awd1779/spider-bot-8/docs/images/body_inside.png

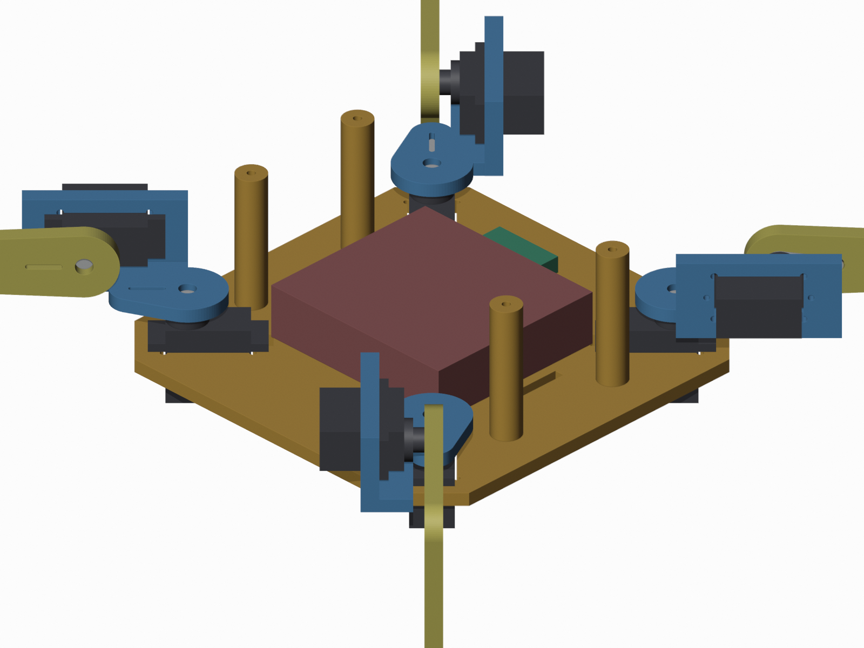
docs/images/body_inside.png
