awd1779/spider-bot-8/docs/images/shoulder_closeup.png

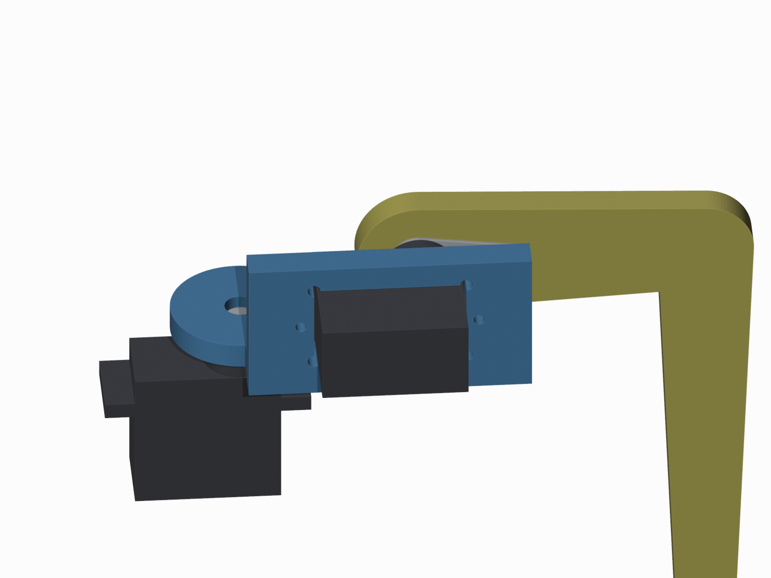
docs/images/shoulder_closeup.png
