awd1779/spider-bot-8/hardware/step/assembly.step

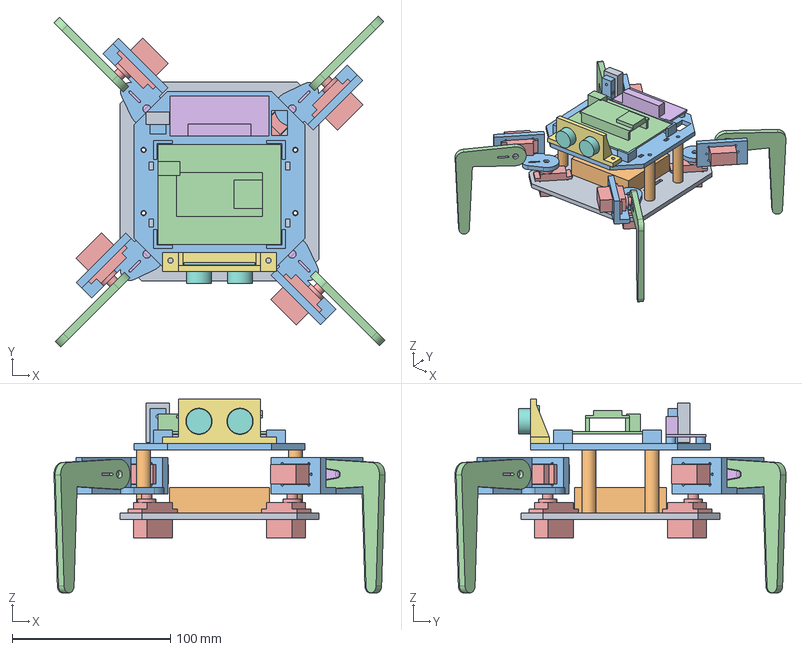
[picture p6: CAD file, 2026-10-23]
hardware/step/assembly.step
209.4 x 209.4 x 122.5 mm
body_bottom
spacer0
spacer1
spacer2
spacer3
body_top
esp32_board
buck_boost_5v
pca9685
sensor_head
sensors_hcsr04_temp
battery_4xAA
leg0_coxa
leg0_leg
leg0_servo_hip
leg0_servo_lift
leg0_horn_hip
leg0_horn_lift
leg1_coxa
leg1_leg
leg1_servo_hip
leg1_servo_lift
leg1_horn_hip
leg1_horn_lift
leg2_coxa
leg2_leg
leg2_servo_hip
leg2_servo_lift
leg2_horn_hip
leg2_horn_lift
leg3_coxa
leg3_leg
leg3_servo_hip
leg3_servo_lift
leg3_horn_hip
leg3_horn_lift
