awd1779/spider-bot-8/hardware/print_one_leg/one_leg_set.stl

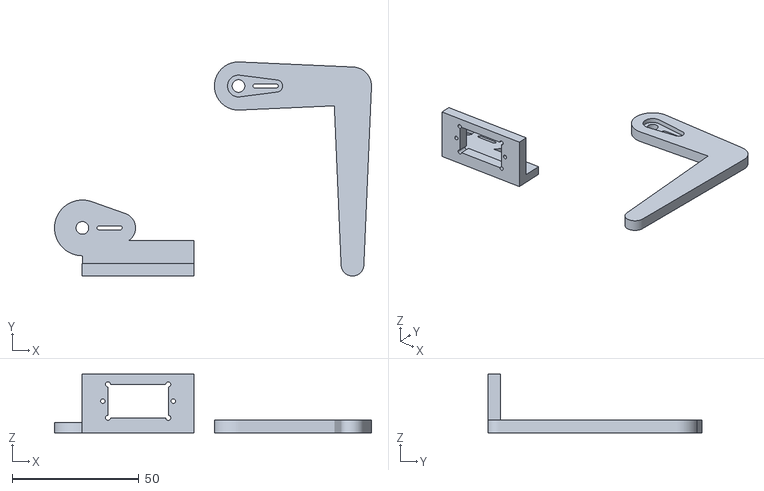
[picture p7: CAD file, 2026-10-23]
hardware/print_one_leg/one_leg_set.stl
125.1 x 84.5 x 23.1
