awd1779/spider-bot-8/hardware/step/spacer.step

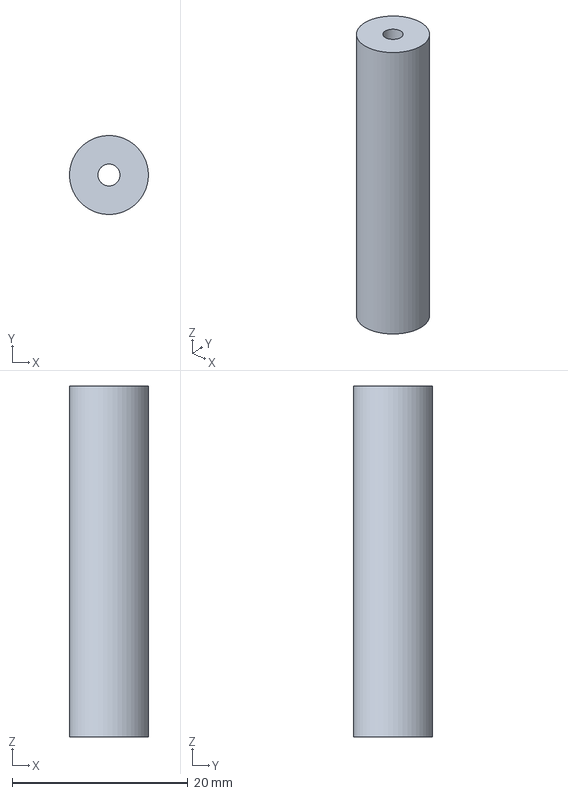
[picture p8: CAD file, 2026-10-23]
hardware/step/spacer.step
8.99 x 9.00 x 40.0 mm
