awd1779/spider-bot-8/hardware/step/leg.step

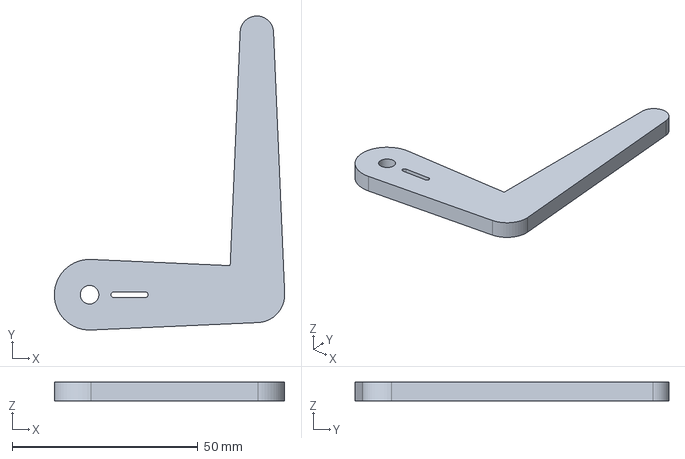
[picture p9: CAD file, 2026-10-23]
hardware/step/leg.step
62.0 x 84.5 x 5.00 mm
