awd1779/spider-bot-8/hardware/step/sensor_head.step

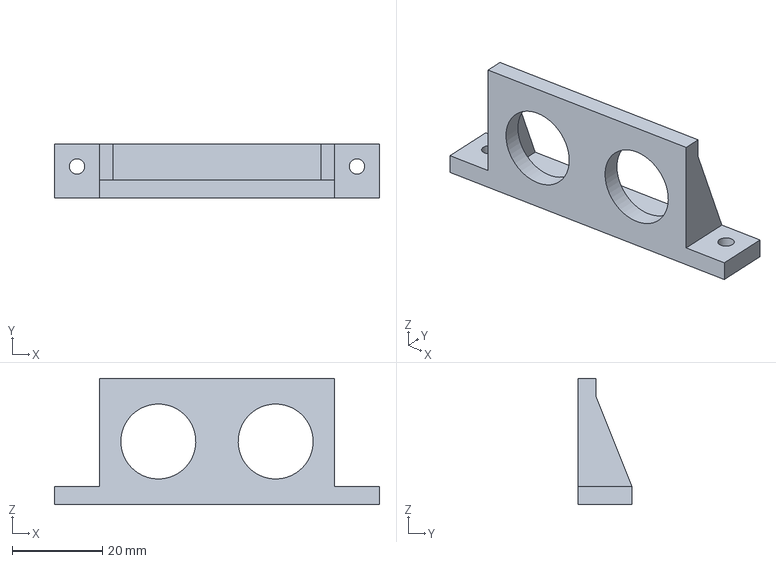
[picture p10: CAD file, 2026-10-23]
hardware/step/sensor_head.step
72.0 x 12.0 x 28.0 mm
