awd1779/spider-bot-8/hardware/step/body_bottom.step

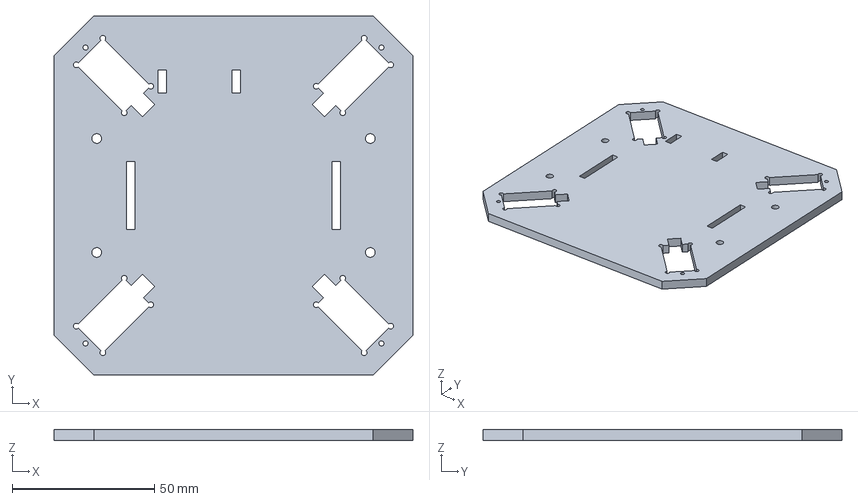
[picture p11: CAD file, 2026-10-23]
hardware/step/body_bottom.step
126.0 x 126.0 x 4.00 mm
