awd1779/spider-bot-8/hardware/step/body_top.step

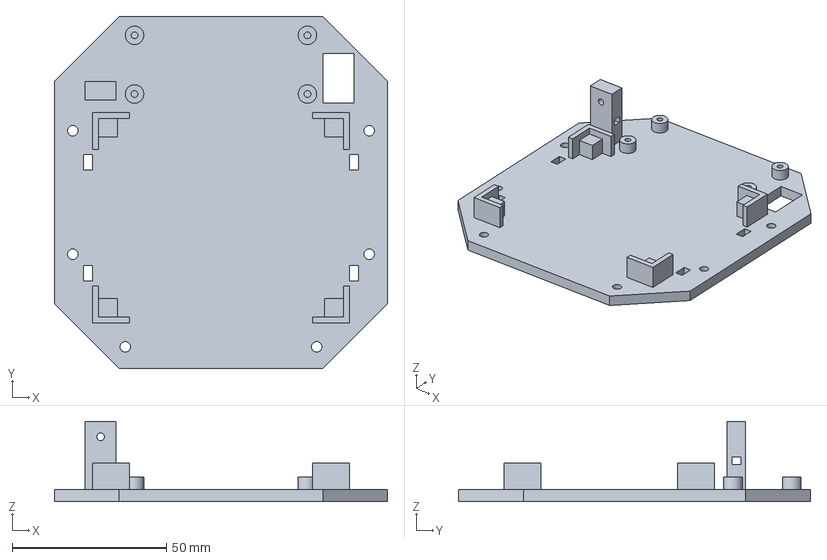
[picture p12: CAD file, 2026-10-23]
hardware/step/body_top.step
108.0 x 114.0 x 26.0 mm
