awd1779/spider-bot-8/hardware/step/leg_test_stand.step

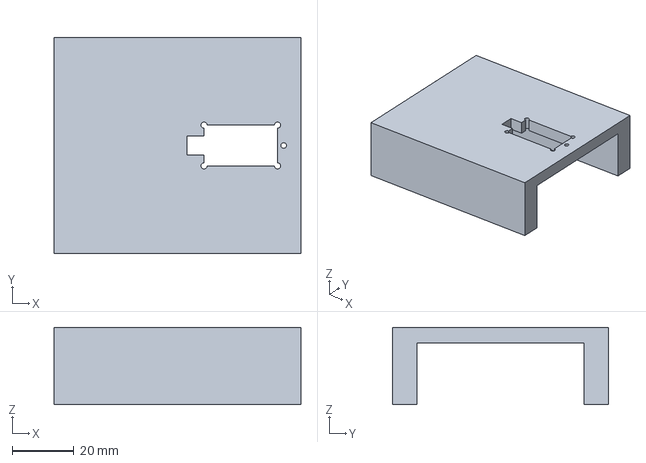
[picture p13: CAD file, 2026-10-23]
hardware/step/leg_test_stand.step
80.0 x 70.0 x 25.0 mm
