awd1779/spider-bot-8/hardware/step/fit_test.step

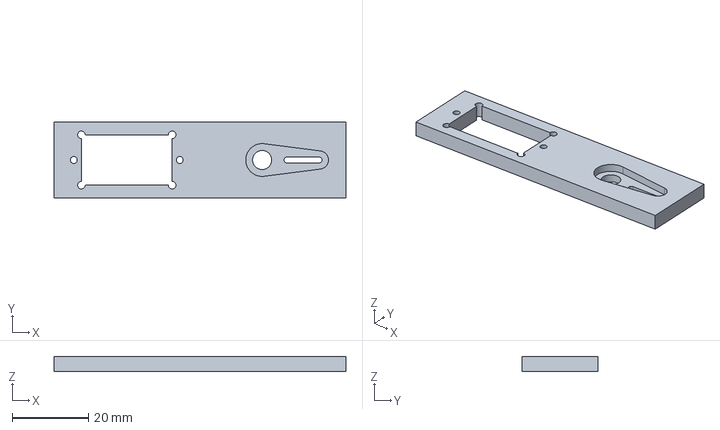
[picture p14: CAD file, 2026-10-23]
hardware/step/fit_test.step
76.6 x 20.0 x 4.00 mm
