awd1779/spider-bot-8/hardware/step/coxa.step

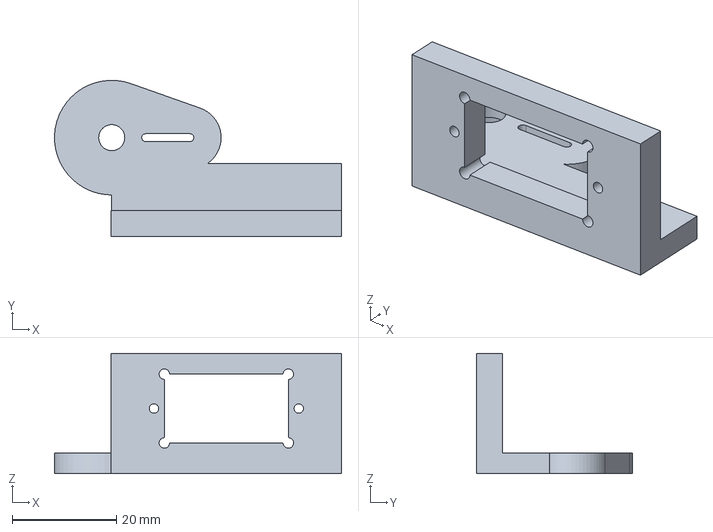
[picture p15: CAD file, 2026-10-23]
hardware/step/coxa.step
55.1 x 30.0 x 23.1 mm
