awd1779/spider-bot-8/hardware/step/leg_interface.step

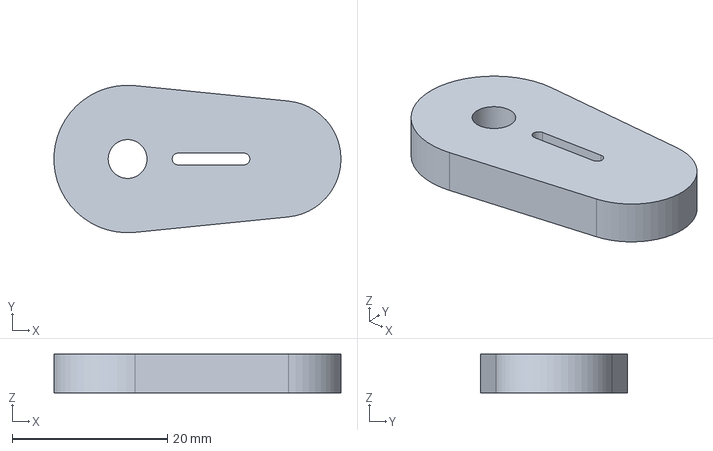
[picture p16: CAD file, 2026-10-23]
hardware/step/leg_interface.step
37.0 x 19.0 x 5.00 mm
