awd1779/spider-bot-8/hardware/step/screw_test.step

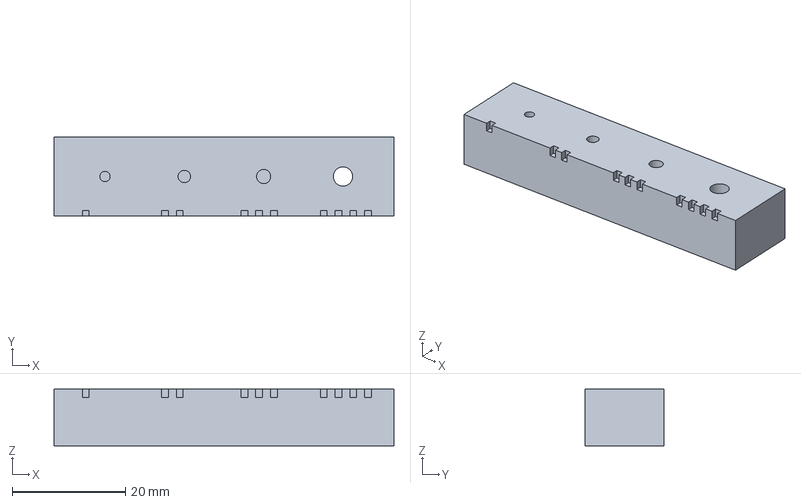
[picture p17: CAD file, 2026-10-23]
hardware/step/screw_test.step
60.0 x 14.0 x 10.0 mm
