awd1779/spider-bot-8/(list of files, cad)

Other CAD files:
hardware/stl/body_bottom.stl
hardware/stl/body_top.stl
hardware/stl/coxa.stl
hardware/stl/fit_test.stl
hardware/stl/leg.stl
hardware/stl/leg_interface.stl
hardware/stl/leg_test_stand.stl
hardware/stl/screw_test.stl
hardware/stl/sensor_head.stl
hardware/stl/spacer.stl
