awd1779/spider-bot-8/docs/manual.html

Student manual · ESP32 + PCA9685 · 8 servos

# Build a walking spider robot

From one servo motor to a robot that walks forward and backward. Work through the chapters in order. Tick the boxes as you go: this page remembers them on this computer.

## Welcome

In this manual you build a four-legged spider robot and teach it to stand up, sit down and walk forward and backward. Each chapter adds one idea and ends with a short check.

The finished spider robot: ESP32 and servo module on top, 4 × AA batteries inside, 8 servos in the legs

The finished spider robot: ESP32 and servo module on top, 4 × AA batteries inside, 8 servos in the legs

The chapters

1. How servo motors work
2. The servo module (PCA9685)
3. Controlling servo motors with code
4. Assembly and calibration
5. Stand up and sit down
6. Walk forward
7. Walk backward
8. The easy way: the SpiderBot8 library

Parts

Part | Qty
ESP32 38-pin board on its expansion board, plus USB cable | 1
MG90S servo motor (with single-arm horn and small screws) | 8
PCA9685 16-channel servo module | 1
4 × AA battery holder with switch, plus 4 AA batteries | 1
Jumper wires, female to female | 4
3D-printed parts: body plate, lid, 4 spacers, 4 shoulders, 4 legs, sensor head | 1 set
M2 × 5 or M2 × 6 self-tapping screws (for the horns) | 16
M3 screws (body and lid), M2.5 screws (servo module), zip ties, Velcro strap | 1 set

Software (set up once)

1. Install Arduino IDE 2.
2. Tools → Board → Boards Manager: search esp32, install esp32 by Espressif Systems.
3. Tools → Board: choose ESP32 Dev Module. Tools → Port: choose the port that appears when you plug in the ESP32.
4. Tools → Manage Libraries: search Adafruit PWM Servo Driver and install it.
5. In the Serial Monitor, set the speed to 115200 baud and the line ending to Newline.

Upload stuck at "Connecting..."? Hold the BOOT button on the ESP32 until the upload starts, then let go.

Safety rules

- Unplug the batteries before you change any wire.
- The batteries go only into the green terminal on the servo module. Never connect them to the ESP32 pins.
- Never turn a servo shaft by hand. Let the code move it.
- If anything gets hot or smells, switch off the batteries and tell your teacher.

## Chapter 1 · How servo motors work

A servo is a motor that turns to an exact angle and holds it there. An ordinary motor just spins while it has power. A servo checks where its shaft is and keeps correcting until it reaches the angle you asked for. The spider uses 8 of them. On each leg, one swings the leg forward and back (hip), and one lifts it up and down (lift).

### 1.1 What's inside

1. Control board: reads the signal and decides which way to drive the motor.
2. DC motor: small and fast, but weak on its own.
3. Gearbox: metal gears in the MG90S slow the motor down and make it much stronger.
4. Potentiometer: a knob joined to the output shaft. It tells the board the shaft's real angle.

The board compares the angle it was told with the angle the potentiometer reads, and drives the motor until they match. This is called a closed loop. It's why a servo pushes back when you try to move it.

### 1.2 MG90S at a glance

Spec | Value
Rotation | about 0° to 180°
Supply voltage | 4.8 to 6.0 V
Strength (stall torque) | about 1.8 kg·cm at 4.8 V, 2.2 kg·cm at 6 V
Speed | about 0.10 s per 60° at 4.8 V
Current | about 10 mA resting, 100–250 mA moving, up to 700 mA when blocked
Weight | 13.4 g

What does 1.8 kg·cm mean? The servo can just hold 1.8 kg on an arm 1 cm long, or 0.9 kg on an arm 2 cm long. A longer arm makes it weaker. Our robot weighs about 460 g, and each lift servo carries about 115 g at the foot. That's well inside what an MG90S can hold, but only if the foot isn't too far out to the side (Chapter 5).

### 1.3 Pulse length sets the angle

The orange signal wire carries a pulse: it switches on for a short time, then off, 50 times every second (every 20 ms). The length of the on part tells the servo which angle to go to.

Pulse length | Angle
500 µs (0.5 ms) | 0°
975 µs | 45°
1450 µs | 90° (centre)
1925 µs | 135°
2400 µs | 180°

Every 1° adds about 10.56 µs:

pulse (µs) = 500 + angle × 10.56

Drag the slider to see the pulse and the horn move together:

Angle 90°

0°45°90°135°180°

Supply 4.8 V6.0 V

1450 µsDrag the slider or pick an angle

Every degree adds about 10.6 µs

Only the length of the 5 V part matters

The voltage changes the speed, not where it stops

What does the battery voltage change? Not the angle. At 4.8 V or 6 V, a 1450 µs pulse means 90°. A higher voltage only makes the servo faster and stronger. Flat batteries make it weak, slow and jittery.

### 1.4 The three wires

Wire colour | Job | Goes to
Brown | GND (−) | battery − (through the servo module)
Red | power (+), 4.8–6 V | battery + (through the servo module)
Orange | signal (the pulse) | a servo module channel

### 1.5 The horn and its teeth

The horn pushes onto the shaft's teeth (the spline). The MG90S shaft has about 20 teeth, so the horn can only go on in steps of about 18°. It's very unlikely to point exactly where you want: it will usually be a few degrees off. That's why we centre every servo with code before fitting the horn (4.2), then fix the last few degrees with trim numbers in the code (4.9).

Check yourself (Chapter 1)

- What part inside the servo measures the real angle?
- What pulse length gives 90°? And 135°?
- Does a higher battery voltage change the angle? What does it change?
- Why can't a horn point at exactly any angle you like?

## Chapter 2 · The servo module (PCA9685)

The ESP32 could make servo pulses itself, but 8 servos cause two problems:

- Power: 8 moving servos can pull 2–3 A. The ESP32 and its USB cable can give only about 0.5 A. The board would keep resetting.
- Pins and timing: 8 servos need 8 pins all sending perfect pulses, all the time, while the ESP32 is busy with other jobs.

The PCA9685 module solves both. It makes the pulses for up to 16 servos by itself. The servos take their power from the batteries through the module's green terminal, not from the ESP32. The ESP32 only sends commands like "channel 4: 1450 µs" over two wires called I2C.

### 2.1 The module's pins

Pin | Job | Connect to
GND | ground | ESP32 GND
OE | output enable | leave it unconnected
SCL | I2C clock | ESP32 GPIO 22
SDA | I2C data | ESP32 GPIO 21
VCC | power for the chip (3.3 V) | ESP32 3V3
V+ | servo power | leave it: the green terminal feeds it
Green terminal | servo power in | 4 × AA pack: red to V+, black to GND
16 × 3-pin rows | servo plugs, channels 0–15 | brown wire on the GND side

I2C is a way for chips to talk over two shared wires, SDA (data) and SCL (clock). Every device has an address. The PCA9685 is at 0x40.

### 2.2 Wiring

Four wires between the boards, the battery only into the green terminal.

There are two separate power supplies here. The USB cable powers the ESP32, and the ESP32's 3V3 pin powers the module's chip. The batteries power only the servos. The GND wire joins the two, so the signals have a common reference.

Check the battery polarity at the green terminal before you switch on: red to V+, black to GND. The wrong way round can destroy the module.

### 2.3 Activity: find the module

Upload this sketch, open the Serial Monitor, and check that the ESP32 can see the module.

Copy

// spider-bot-8 by DRODI | MIT licence | https://github.com/awd1779/spider-bot-8
// P1 - I2C scanner
// Finds every I2C device on SDA / SCL and prints its address.
// The PCA9685 servo module should show up as 0x40.
// ESP32: SDA = GPIO 21, SCL = GPIO 22

#include <Wire.h>

void setup() {
  Serial.begin(115200);
  Wire.begin();
  delay(500);
  Serial.println("Scanning I2C...");
}

void loop() {
  int found = 0;
  for (int address = 1; address < 127; address++) {
    Wire.beginTransmission(address);
    if (Wire.endTransmission() == 0) {        // 0 = a device answered
      Serial.print("Found a device at 0x");
      if (address < 16) Serial.print("0");
      Serial.println(address, HEX);
      found++;
    }
  }
  if (found == 0) Serial.println("Nothing found. Check VCC, GND, SDA and SCL.");
  Serial.println("---");
  delay(3000);                                 // scan again every 3 seconds
}

Code | What it does
Wire.begin(); | Starts I2C. On the ESP32 that's SDA = GPIO 21, SCL = GPIO 22
Wire.beginTransmission(address); | "Is anyone at this address?"
Wire.endTransmission() == 0 | 0 means a device answered
Serial.println(address, HEX); | Prints the address in hexadecimal, like 40

You should see Found a device at 0x40. If you see "Nothing found", check the four wires: VCC, GND, SDA and SCL. SDA and SCL swapped is the most common mistake.

Check yourself (Chapter 2)

- Give two reasons we use the servo module instead of plugging servos into the ESP32.
- Which two wires does I2C use? What are they connected to on the ESP32?
- Where do the batteries connect? Where must they never connect?
- The scanner found 0x40. What is at that address?

## Chapter 3 · Controlling servo motors

### 3.1 Activity: move one servo

Plug one servo into channel 0, brown wire on the GND side. Switch on the batteries, then upload:

Copy

// spider-bot-8 by DRODI | MIT licence | https://github.com/awd1779/spider-bot-8
// P2 - Move one servo with the PCA9685
// Servo on channel 0. It goes to 90, 45 and 135 degrees, then sweeps smoothly.

#include <Wire.h>
#include <Adafruit_PWMServoDriver.h>

Adafruit_PWMServoDriver pca = Adafruit_PWMServoDriver(0x40);

// Angle (0 to 180) -> pulse length in microseconds, then send it
void writeServo(int channel, float angle) {
  int us = 500 + angle * 10.56;
  pca.writeMicroseconds(channel, us);
}

void setup() {
  Wire.begin();                       // ESP32: SDA = 21, SCL = 22
  pca.begin();
  pca.setOscillatorFrequency(27000000);
  pca.setPWMFreq(50);                 // servos want 50 pulses a second
  delay(10);

  writeServo(0, 90);  delay(1000);    // centre
  writeServo(0, 45);  delay(1000);
  writeServo(0, 135); delay(1000);
  writeServo(0, 90);  delay(1000);
}

void loop() {
  for (int a = 90; a <= 135; a++) {   // count up, 1 degree at a time
    writeServo(0, a);
    delay(15);                        // 15 ms per degree sets the speed
  }
  for (int a = 135; a >= 45; a--) {   // count back down
    writeServo(0, a);
    delay(15);
  }
  for (int a = 45; a <= 90; a++) {    // back to the centre
    writeServo(0, a);
    delay(15);
  }
  delay(500);
}

Code | What it does
#include <Adafruit_PWMServoDriver.h> | Loads the library that talks to the PCA9685

Adafruit_PWMServoDriver pca = ...(0x40); | Creates pca, the module at address 0x40
pca.setPWMFreq(50); | 50 pulses a second: what servos expect
pca.setOscillatorFrequency(27000000); | Tells the library the chip's real clock speed, so the pulse lengths come out right
void writeServo(int channel, float angle) | Our own function: changes an angle into a pulse length (1.3) and sends it
pca.writeMicroseconds(channel, us); | "Channel 0: send pulses this many µs long", from now until we say otherwise
for (int a = 90; a <= 135; a++) | Counts 90, 91, 92 ... 135. Moving 1° at a time makes the movement smooth
delay(15); | 15 ms per degree. Smaller is faster

Try it: change delay(15) to delay(5), then to delay(40). What happens?

### 3.2 Activity: the servo tester

This sketch lets you type any channel and angle. You'll use it again to check servos and wiring.

Copy

// spider-bot-8 by DRODI | MIT licence | https://github.com/awd1779/spider-bot-8
// P3 - Servo tester
// Type a channel and an angle in the Serial Monitor (115200 baud, "Newline"), e.g.
//   0 90     -> channel 0 to 90 degrees
//   5 120    -> channel 5 to 120 degrees
// It prints the pulse length it sent.

#include <Wire.h>
#include <Adafruit_PWMServoDriver.h>

Adafruit_PWMServoDriver pca = Adafruit_PWMServoDriver(0x40);

int writeServo(int channel, float angle) {
  int us = 500 + angle * 10.56;
  pca.writeMicroseconds(channel, us);
  return us;
}

void setup() {
  Serial.begin(115200);
  Wire.begin();
  pca.begin();
  pca.setOscillatorFrequency(27000000);
  pca.setPWMFreq(50);
  delay(10);
  Serial.println("Type: channel angle   (example: 0 90)");
}

void loop() {
  if (Serial.available() == 0) return;          // nothing typed yet
  String line = Serial.readStringUntil('\n');
  int channel = -1, angle = -1;
  if (sscanf(line.c_str(), "%d %d", &channel, &angle) != 2) {
    Serial.println("Type two numbers, e.g. 0 90");
    return;
  }
  if (channel < 0 || channel > 15 || angle < 0 || angle > 180) {
    Serial.println("Channel 0-15, angle 0-180");
    return;
  }
  int us = writeServo(channel, angle);
  Serial.print("Channel "); Serial.print(channel);
  Serial.print(" -> "); Serial.print(angle);
  Serial.print(" deg = "); Serial.print(us); Serial.println(" us");
}

Code | What it does
Serial.readStringUntil('\n') | Reads one line you typed in the Serial Monitor
sscanf(line.c_str(), "%d %d", &channel, &angle) | Splits the line into two whole numbers. It gives back how many it found
if (channel < 0 || channel > 15 ...) | Ignores numbers that don't make sense, so a typing mistake can't hurt a servo

Try it: type 0 90, then 0 0, then 0 180. Then move the plug to channel 5 and type 5 45.

### 3.3 Activity: one leg takes a step

A leg has two servos: the hip (forward and back) and the lift (up and down). Plug the hip servo into channel 0 and the lift servo into channel 1. A step only works if the moves happen in the right order: lift, swing forward, put down, push back.

Copy

// spider-bot-8 by DRODI | MIT licence | https://github.com/awd1779/spider-bot-8
// P4 - Two servos make one leg take a step
// Hip servo on channel 0 (forward / back), lift servo on channel 1 (up / down).

#include <Wire.h>
#include <Adafruit_PWMServoDriver.h>

Adafruit_PWMServoDriver pca = Adafruit_PWMServoDriver(0x40);

const int HIP = 0;     // channel numbers
const int LIFT = 1;

int angleNow[16];      // the PCA9685 can't tell us where a servo is, so we remember

void writeServo(int channel, int angle) {
  pca.writeMicroseconds(channel, 500 + angle * 10.56);
  angleNow[channel] = angle;
}

// Move one servo slowly from where it is now to a new angle
void moveSlow(int channel, int target) {
  int step = (target > angleNow[channel]) ? 1 : -1;
  while (angleNow[channel] != target) {
    writeServo(channel, angleNow[channel] + step);
    delay(8);
  }
}

void setup() {
  Wire.begin();
  pca.begin();
  pca.setOscillatorFrequency(27000000);
  pca.setPWMFreq(50);
  delay(10);
  writeServo(HIP, 90);
  delay(300);
  writeServo(LIFT, 90);
  delay(1000);
}

void loop() {
  moveSlow(LIFT, 115);   // 1. lift the foot
  moveSlow(HIP, 110);    // 2. swing it forward in the air
  moveSlow(LIFT, 90);    // 3. put it down
  moveSlow(HIP, 90);     // 4. push back along the ground
  delay(500);
}

Code | What it does
int angleNow[16]; | An array: 16 numbers in a row, one for each channel. The module can't tell us where a servo is, so the code remembers it
angleNow[channel] = angle; | Remembers where we sent it
void moveSlow(int channel, int target) | Moves one servo 1° at a time from where it is now to target
(target > angleNow[channel]) ? 1 : -1 | Count up (+1) if the target is bigger, otherwise down (−1)
while (angleNow[channel] != target) | Keep going until it gets there

Try it: swap lines 2 and 3 in loop(). The foot now drags along the floor. Why?

### 3.4 From servo angles to leg angles

In the robot code we stop thinking in servo angles (0–180) and think in leg angles instead. 0 means the middle:

Leg angle | Meaning
hip = 0 | the leg points straight out
hip > 0 | the foot moves forward (towards the sensor head)
lift = 0 | the top of the leg is level
lift > 0 | the foot goes up
lift < 0 | the foot goes down, pushing the body up

The code changes leg angles into servo angles with one line:

servo angle = 90 + DIR × leg angle + TRIM

- TRIM fixes the few degrees the horn is off (1.5).
- DIR is +1 or −1. The servos on the left and right sides face opposite ways, so the same servo turn moves a left foot back but a right foot forward. DIR flips it so that "+" always means forward.

You'll find each leg's TRIM and DIR in Chapter 4.

Check yourself (Chapter 3)

- What does pca.writeMicroseconds(0, 1450) do?
- Why does the code keep the angles in an array?
- In 3.3, why must the foot lift before the hip swings forward?
- A leg has TRIM = 4 and DIR = −1. Which servo angle gives hip = 10?

## Chapter 4 · Assembly and calibration

The robot pulled apart: bottom plate with the battery inside, 4 spacers, lid with the ESP32 board and servo module, and the 4 legs

The robot pulled apart: bottom plate with the battery inside, 4 spacers, lid with the ESP32 board and servo module, and the 4 legs

### 4.1 Before you start

Printed part | Qty
body_bottom (flat plate) | 1
body_top (lid) | 1
spacer (lid pillars) | 4
coxa (shoulder) | 4
leg | 4
sensor_head | 1

Print one shoulder and one leg first and test them (4.2–4.4) before printing the rest.

### 4.2 Centre every servo first

Plug all 8 servos into the module: channels 0, 1, 4, 5, 8, 9, 12 and 13. Switch on the batteries and upload:

Copy

// spider-bot-8 by DRODI | MIT licence | https://github.com/awd1779/spider-bot-8
// P5 - Centre all 8 servos (run this BEFORE you fit the horns)
// Every leg servo goes to exactly 90 degrees (1450 us) and stays there.
// Leave it running while you push the horns and legs on.

#include <Wire.h>
#include <Adafruit_PWMServoDriver.h>

Adafruit_PWMServoDriver pca = Adafruit_PWMServoDriver(0x40);

const int CHANNELS[8] = {0, 1, 4, 5, 8, 9, 12, 13};   // hip + lift of the 4 legs

void setup() {
  Serial.begin(115200);
  Wire.begin();
  pca.begin();
  pca.setOscillatorFrequency(27000000);
  pca.setPWMFreq(50);
  delay(10);
  for (int i = 0; i < 8; i++) {
    pca.writeMicroseconds(CHANNELS[i], 1450);         // 90 degrees
    delay(300);                                       // one at a time: no big current spike
  }
  Serial.println("All 8 servos are at 90 degrees. Fit the horns now.");
}

void loop() {
}

Every servo is now at exactly 90°. Leave the sketch running while you fit the horns (4.3), so nothing gets pushed off centre. Label each servo with its channel number (a piece of tape on the cable).

### 4.3 Fit the horns

One joint: the horn drops into the pocket on the leg, 2 small screws go through the horn's holes into the slot, and the leg pushes onto the servo

One joint: the horn drops into the pocket on the leg, 2 small screws go through the horn's holes into the slot, and the leg pushes onto the servo

1. Drop a single-arm horn into the pocket on the leg, spline hole facing out.
2. Drive 2 M2 self-tapping screws through 2 horn holes that sit over the slot. Leave a gap between them, for example the 2nd and 5th holes from the centre. The screws cut their own thread into the sides of the slot.
3. Do the same on the flat plate of each shoulder.

### 4.4 Build each leg

One leg built: the hip servo (left), the blue shoulder with the lift servo in its wall, and the yellow leg on the lift servo

One leg built: the hip servo (left), the blue shoulder with the lift servo in its wall, and the yellow leg on the lift servo

1. Push the lift servo through the shoulder's wall, shaft on the leg side, and screw its tabs on with the screws from its bag.
2. Push the leg onto the lift servo's shaft so that the top of the L is level and the foot points down. Fit the servo's small centre screw through the hole in the middle.
3. Repeat for all 4 legs. Every leg is built the same way.

### 4.5 The body

Inside the body: hip servos in the 4 corners, the battery pack in the middle, and the 4 spacers

Inside the body: hip servos in the 4 corners, the battery pack in the middle, and the 4 spacers

1. Push the 4 hip servos into the corners of the bottom plate, shafts up, and screw their tabs on. The cables go down through the notch.
2. Strap the 4 × AA holder to the middle of the plate with the Velcro strap. Bring its wires up to the back-right corner.
3. Screw the 4 spacers on from under the plate with M3 screws.
4. Push each shoulder onto its hip servo so that it points straight out from the corner, diagonally. Fit the centre screw.

### 4.6 The lid

1. Sit the ESP32 expansion board in the 4 corner holders. Pass 2 zip ties through the slots beside it and over the board. The USB socket faces the side.
2. Screw the PCA9685 to the 4 short posts at the back (M2.5).
3. Bolt the sensor head to the 2 front holes (M3).
4. Feed the servo cables and the battery wires up through the slot at the back-right. Screw the lid onto the spacers.

### 4.7 Plug in the servos

Top view: the front (sensor head) is at the top of the picture

Top view: the front (sensor head) is at the top of the picture

Leg | Hip channel | Lift channel
0 rear-left | 0 | 1
1 rear-right | 4 | 5
2 front-right | 8 | 9
3 front-left | 12 | 13

Left and right are as the robot sees them, looking forward. Brown wires go on the GND side of every plug.

### 4.8 Why calibrate?

Every servo is a little different, and the horns sit up to about 9° off (1.5). Calibration finds two numbers for every joint:

- TRIM (degrees): what to add so that leg angle 0 really is straight out and level.
- DIR (+1 or −1): which way round is forward and up for that servo.

### 4.9 Activity: calibrate

Upload this sketch and open the Serial Monitor:

Full sketch: P6_calibrate.ino

Copy

// spider-bot-8 by DRODI | MIT licence | https://github.com/awd1779/spider-bot-8
// P6 - Calibrate the robot
// Open the Serial Monitor (115200 baud, "Newline") and type:
//   test        -> moves each joint a little, one at a time: watch the direction
//   h 0 5       -> hip trim of leg 0 = 5 degrees   (legs: 0 rear-left, 1 rear-right,
//   l 0 -3      -> lift trim of leg 0 = -3 degrees          2 front-right, 3 front-left)
//   fh 0        -> flip the hip direction of leg 0
//   fl 0        -> flip the lift direction of leg 0
//   print       -> prints your numbers, ready to paste into the next sketches

#include <Wire.h>
#include <Adafruit_PWMServoDriver.h>

Adafruit_PWMServoDriver pca = Adafruit_PWMServoDriver(0x40);

const char* LEG_NAME[4] = {"rear-left", "rear-right", "front-right", "front-left"};
const int HIP_CH[4]  = {0, 4, 8, 12};
const int LIFT_CH[4] = {1, 5, 9, 13};

int HIP_TRIM[4]  = {0, 0, 0, 0};
int LIFT_TRIM[4] = {0, 0, 0, 0};
int HIP_DIR[4]   = {-1, 1, 1, -1};
int LIFT_DIR[4]  = {-1, -1, -1, -1};

void writeServo(int ch, float deg) {
  pca.writeMicroseconds(ch, 500 + deg * 10.56);
}

void setLeg(int leg, float hip, float lift) {
  writeServo(HIP_CH[leg], 90 + HIP_DIR[leg] * hip + HIP_TRIM[leg]);
  writeServo(LIFT_CH[leg], 90 + LIFT_DIR[leg] * lift + LIFT_TRIM[leg]);
}

void allZero() {
  for (int leg = 0; leg < 4; leg++) setLeg(leg, 0, 0);
}

void directionTest() {
  for (int leg = 0; leg < 4; leg++) {
    Serial.print("Leg "); Serial.print(leg); Serial.print(" ("); Serial.print(LEG_NAME[leg]);
    Serial.println("): the foot should swing FORWARD (towards the sensor head)");
    setLeg(leg, 20, 0); delay(1200); setLeg(leg, 0, 0); delay(600);
    Serial.println("   ... and now the foot should go UP");
    setLeg(leg, 0, 20); delay(1200); setLeg(leg, 0, 0); delay(600);
  }
  Serial.println("Wrong way? Type fh <leg> or fl <leg>, then test again.");
}

void printNumbers() {
  Serial.println("Copy these 4 lines into the next sketches:");
  const char* names[4] = {"HIP_TRIM", "LIFT_TRIM", "HIP_DIR", "LIFT_DIR"};
  int* arrays[4] = {HIP_TRIM, LIFT_TRIM, HIP_DIR, LIFT_DIR};
  for (int k = 0; k < 4; k++) {
    Serial.print("int "); Serial.print(names[k]); Serial.print("[4] = {");
    for (int i = 0; i < 4; i++) { Serial.print(arrays[k][i]); if (i < 3) Serial.print(", "); }
    Serial.println("};");
  }
}

void setup() {
  Serial.begin(115200);
  Wire.begin();
  pca.begin();
  pca.setOscillatorFrequency(27000000);
  pca.setPWMFreq(50);
  delay(10);
  for (int leg = 0; leg < 4; leg++) { setLeg(leg, 0, 0); delay(300); }
  Serial.println("All joints at 0. Each leg should point straight out, level.");
  Serial.println("Commands: test | h <leg> <deg> | l <leg> <deg> | fh <leg> | fl <leg> | print");
}

void loop() {
  if (Serial.available() == 0) return;
  String line = Serial.readStringUntil('\n');
  char cmd[8] = "";
  int leg = -1, value = 0;
  int n = sscanf(line.c_str(), "%7s %d %d", cmd, &leg, &value);
  String c = cmd;
  if (c == "test") { directionTest(); return; }
  if (c == "print") { printNumbers(); return; }
  if (n < 2 || leg < 0 || leg > 3) { Serial.println("Which leg? 0-3"); return; }
  if (c == "h" && n == 3) HIP_TRIM[leg] = value;
  else if (c == "l" && n == 3) LIFT_TRIM[leg] = value;
  else if (c == "fh") HIP_DIR[leg] = -HIP_DIR[leg];
  else if (c == "fl") LIFT_DIR[leg] = -LIFT_DIR[leg];
  else { Serial.println("Commands: test | h <leg> <deg> | l <leg> <deg> | fh <leg> | fl <leg> | print"); return; }
  allZero();
  Serial.print("Leg "); Serial.print(leg); Serial.print(" ("); Serial.print(LEG_NAME[leg]);
  Serial.print("): hip trim "); Serial.print(HIP_TRIM[leg]);
  Serial.print(", lift trim "); Serial.print(LIFT_TRIM[leg]);
  Serial.print(", hip dir "); Serial.print(HIP_DIR[leg]);
  Serial.print(", lift dir "); Serial.println(LIFT_DIR[leg]);
}
1. Every joint goes to 0. Look at each leg from above: the shoulder should point straight out from the corner, diagonally. Look from the side: the top of the leg should be level.
2. If a leg is off, type a trim and watch it move. For example, h 0 5 moves leg 0's hip trim to +5°, and l 2 -4 moves leg 2's lift trim to −4°. Try numbers until the joint looks right.
3. Type test. Each leg swings its foot, then lifts it, one at a time. Read the Serial Monitor: the foot must swing forward (towards the sensor head), then go up. If one goes the wrong way, flip it: fh 1 for leg 1's hip, fl 1 for its lift. Type test again.
4. Type print. Copy the 4 lines it prints and paste them into the next sketches (P7, P8 and P9), over the lines between PASTE YOUR CALIBRATION HERE and the dashed line.

Record your numbers here too:

Leg | Hip trim | Lift trim | Hip dir | Lift dir
0 rear-left
1 rear-right
2 front-right
3 front-left

Trim more than about 10°? The horn is a whole tooth out. Take the leg off, run P5 again, and refit the horn one tooth round.

Checklist (Chapter 4)

- All 8 servos centred with P5 before the horns went on
- Every horn held by 2 screws
- Shoulders point straight out, diagonally
- Servos plugged into the right channels, brown wire on GND
- At 0, every leg points straight out and is level (trims done)
- test: every foot swings forward, then goes up (directions done)
- Calibration numbers copied into P7, P8 and P9

## Chapter 5 · Stand up and sit down

### 5.1 The idea

Standing and sitting use only the 4 lift servos. Turning a foot down pushes the body up. Turning it up lowers the body until it rests on the floor.

Side view of one leg. Only the lift servo moves: turning the foot down pushes the body up.

Pose | Lift angle | What happens
Sit | +35° (SIT) | feet up, the body rests on the floor
Stand | −15° (STAND) | feet down, the body is about 4 cm off the floor

Why stand at −15° and not 0°? At −15° the foot sits closer in, under the lift servo. The robot's weight then pushes on a shorter arm (about 24 mm instead of 45 mm), so each servo needs about half the strength to hold it up (1.2).

### 5.2 The robot code

From now on, every sketch starts with the same robot code. Three functions do most of the work.

setLeg: put one leg at a hip and lift angle

Copy

// Put one leg at a hip angle (+ = forward) and a lift angle (+ = foot up)
void setLeg(int leg, float hip, float lift) {
  hip = constrain(hip, -LIMIT, LIMIT);
  lift = constrain(lift, -LIMIT, LIMIT);
  writeServo(HIP_CH[leg], 90 + HIP_DIR[leg] * hip + HIP_TRIM[leg]);
  writeServo(LIFT_CH[leg], 90 + LIFT_DIR[leg] * lift + LIFT_TRIM[leg]);
  hipNow[leg] = hip;
  liftNow[leg] = lift;
}

Code | What it does
constrain(hip, -LIMIT, LIMIT) | Never more than 35° from the middle, so a leg can't hit the body
90 + HIP_DIR[leg] * hip + HIP_TRIM[leg] | Leg angle → servo angle (3.4)
hipNow[leg] = hip; | Remembers where the leg is now

moveLegs: move all 4 legs smoothly, at the same time

Copy

// Move all 4 legs together to new angles, taking ms milliseconds
void moveLegs(float hip[4], float lift[4], int ms) {
  float hip0[4], lift0[4];
  for (int i = 0; i < 4; i++) { hip0[i] = hipNow[i]; lift0[i] = liftNow[i]; }
  int steps = max(1, ms / 20);
  for (int s = 1; s <= steps; s++) {
    float f = (float)s / steps;                     // 0 -> 1
    for (int i = 0; i < 4; i++)
      setLeg(i, hip0[i] + (hip[i] - hip0[i]) * f, lift0[i] + (lift[i] - lift0[i]) * f);
    delay(20);
  }
}

Code | What it does
hip0[i] = hipNow[i]; | Where each leg starts
int steps = max(1, ms / 20); | One small move every 20 ms. 1500 ms = 75 small moves
float f = (float)s / steps; | How far through the move we are: 0.01, 0.02 ... 1.0
hip0[i] + (hip[i] - hip0[i]) * f | The angle that far between the start and the end. All legs arrive together

standUp and sitDown

Copy

void standUp() {
  float hip[4]  = {0, 0, 0, 0};
  float lift[4] = {STAND, STAND, STAND, STAND};
  moveLegs(hip, lift, 1500);
}

void sitDown() {
  float hip[4]  = {0, 0, 0, 0};
  float lift[4] = {SIT, SIT, SIT, SIT};
  moveLegs(hip, lift, 1500);
}

### 5.3 Activity: stand up and sit down

Paste your calibration numbers into the sketch, put the robot on the floor, switch on the batteries and upload:

Full sketch: P7_stand_sit.ino

Copy

// spider-bot-8 by DRODI | MIT licence | https://github.com/awd1779/spider-bot-8
// P7 - Stand up and sit down
// Serial Monitor (115200 baud):  s = stand up,  d = sit down

#include <Wire.h>
#include <Adafruit_PWMServoDriver.h>

Adafruit_PWMServoDriver pca = Adafruit_PWMServoDriver(0x40);

// Legs: 0 rear-left, 1 rear-right, 2 front-right, 3 front-left
const int HIP_CH[4]  = {0, 4, 8, 12};
const int LIFT_CH[4] = {1, 5, 9, 13};

// ---- PASTE YOUR CALIBRATION HERE (from P6) ----
int HIP_TRIM[4]  = {0, 0, 0, 0};
int LIFT_TRIM[4] = {0, 0, 0, 0};
int HIP_DIR[4]   = {-1, 1, 1, -1};
int LIFT_DIR[4]  = {-1, -1, -1, -1};
// -----------------------------------------------

const int LIMIT = 35;          // never more than 35 degrees from centre
const float STAND = -15;       // lift angle when standing (foot pushed down)
const float SIT = 35;          // lift angle when sitting (feet up, body on the floor)

float hipNow[4], liftNow[4];   // where every joint is now

void writeServo(int ch, float deg) {
  pca.writeMicroseconds(ch, 500 + deg * 10.56);
}

// Put one leg at a hip angle (+ = forward) and a lift angle (+ = foot up)
void setLeg(int leg, float hip, float lift) {
  hip = constrain(hip, -LIMIT, LIMIT);
  lift = constrain(lift, -LIMIT, LIMIT);
  writeServo(HIP_CH[leg], 90 + HIP_DIR[leg] * hip + HIP_TRIM[leg]);
  writeServo(LIFT_CH[leg], 90 + LIFT_DIR[leg] * lift + LIFT_TRIM[leg]);
  hipNow[leg] = hip;
  liftNow[leg] = lift;
}

// Move all 4 legs together to new angles, taking ms milliseconds
void moveLegs(float hip[4], float lift[4], int ms) {
  float hip0[4], lift0[4];
  for (int i = 0; i < 4; i++) { hip0[i] = hipNow[i]; lift0[i] = liftNow[i]; }
  int steps = max(1, ms / 20);
  for (int s = 1; s <= steps; s++) {
    float f = (float)s / steps;                     // 0 -> 1
    for (int i = 0; i < 4; i++)
      setLeg(i, hip0[i] + (hip[i] - hip0[i]) * f, lift0[i] + (lift[i] - lift0[i]) * f);
    delay(20);
  }
}

void standUp() {
  float hip[4]  = {0, 0, 0, 0};
  float lift[4] = {STAND, STAND, STAND, STAND};
  moveLegs(hip, lift, 1500);
}

void sitDown() {
  float hip[4]  = {0, 0, 0, 0};
  float lift[4] = {SIT, SIT, SIT, SIT};
  moveLegs(hip, lift, 1500);
}

void setup() {
  Serial.begin(115200);
  Wire.begin();
  pca.begin();
  pca.setOscillatorFrequency(27000000);
  pca.setPWMFreq(50);
  delay(10);
  for (int leg = 0; leg < 4; leg++) { setLeg(leg, 0, SIT); delay(300); }   // start sitting
  Serial.println("s = stand up, d = sit down");
}

void loop() {
  if (Serial.available() == 0) return;
  char c = Serial.read();
  if (c == 's') { Serial.println("Standing up"); standUp(); }
  if (c == 'd') { Serial.println("Sitting down"); sitDown(); }
}

Type s to stand up and d to sit down.

Try it:

- Change 1500 in standUp() to 600. What changes? Is it better or worse?
- Change STAND to -25. The robot stands taller. Does it still stand steadily?
- Make the robot do 3 "push-ups" in a row with a for loop.

Check yourself (Chapter 5)

- Which servos move when the robot stands up?
- What does moveLegs do that setLeg doesn't?
- Why does the robot stand at −15° and not 0°?

## Chapter 6 · Walk forward

### 6.1 Why the robot can fall over

Hold a table up with 4 legs, then take one away. It stays up only if its weight is over the triangle made by the other 3 legs. The point where the weight acts is the centre of mass. For our robot it's near the middle of the body.

When the robot lifts one foot, the other 3 make a triangle on the floor. If the centre of mass is outside or on the edge of that triangle, the robot tips towards the lifted foot. With all 4 legs straight out, the triangle's long edge runs right through the middle, so the robot is on the very edge of tipping.

The fix is to keep the legs spread out unevenly: one step apart from each other. Then the triangle always covers the middle when a leg lifts. This way of walking, with one leg in the air at a time, is called a creep gait. Slow animals and most walking robots use it.

### 6.2 How the creep gait works

The legs move in this order: rear-left → front-left → rear-right → front-right. Each move has 3 parts:

1. Step: lift the leg that is furthest back, carry it to the front in the air, and put it down.
2. Shift: all 4 feet push back together on the floor. The feet don't slide, so the body moves forward.
3. Repeat with the next leg in the order.

Use the buttons to go through one full cycle:

ForwardBackward

◀ Back▶ PlayNext ▶

foot on the floor foot in the air support area centre of mass

Each leg is always one step (STEP = 14°) apart from the next: −2, −1, 0, +1 steps. The leg at −2 is the next one to lift, and it goes to +2. After the shift every leg is one step further back, and a new leg is at −2.

### 6.3 The walking code

moveOneLeg and stepLeg: move one leg while the others stay put

Copy

// Move just one leg; the other three stay where they are
void moveOneLeg(int leg, float hip, float lift, int ms) {
  float h[4], l[4];
  for (int i = 0; i < 4; i++) { h[i] = hipNow[i]; l[i] = liftNow[i]; }
  h[leg] = hip;
  l[leg] = lift;
  moveLegs(h, l, ms);
}

// Lift a leg, carry it to a new hip angle in the air, put it down
void stepLeg(int leg, float hip) {
  moveOneLeg(leg, hipNow[leg], UP, 150);     // 1. foot up
  moveOneLeg(leg, hip, UP, 200);             // 2. swing in the air
  moveOneLeg(leg, hip, STAND, 150);          // 3. foot down
}

Code | What it does
h[i] = hipNow[i]; | Copies where every leg is now ...
h[leg] = hip; | ... then changes only the one we want to move
moveOneLeg(leg, hipNow[leg], UP, 150); | Same hip, foot up (UP = +10°): lifts the foot about 2 cm
moveOneLeg(leg, hip, UP, 200); | Swings it to the new hip angle, still in the air
moveOneLeg(leg, hip, STAND, 150); | Puts it down

shiftBody: all 4 feet push together

Copy

// All 4 feet stay on the floor and every hip turns by "by" degrees.
// by < 0: the feet push back, so the body slides forward.
void shiftBody(float by) {
  float h[4], l[4];
  for (int i = 0; i < 4; i++) { h[i] = hipNow[i] + by; l[i] = liftNow[i]; }
  moveLegs(h, l, 300);
}

getReady: spread the legs into the starting pattern

Copy

// Starting pattern for walking: the legs are at -2, -1, 0 and +1 units,
// in the order they will step (dir = +1 forward, -1 backward)
void getReady(const int order[4], int dir) {
  if (!standing) standUp();
  for (int j = 0; j < 4; j++) {
    int leg = order[j];
    float target = dir * (j - 2) * STEP;
    if (hipNow[leg] != target) stepLeg(leg, target);
  }
}

target = dir * (j - 2) * STEP gives the legs in walking order −2, −1, 0 and +1 steps: −28°, −14°, 0° and +14°.

walkForward: the gait itself

Copy

// Leg order for walking forward: rear-left, front-left, rear-right, front-right
const int FWD_ORDER[4] = {0, 3, 1, 2};

void walkForward(int cycles) {
  getReady(FWD_ORDER, +1);
  for (int c = 0; c < cycles; c++) {
    for (int j = 0; j < 4; j++) {
      stepLeg(FWD_ORDER[j], 2 * STEP);   // the back-most leg steps to the front
      shiftBody(-STEP);                  // all feet push back: the body moves forward
    }
  }
  standStill();
}

Code | What it does
FWD_ORDER[4] = {0, 3, 1, 2} | Leg numbers in walking order: rear-left, front-left, rear-right, front-right
stepLeg(FWD_ORDER[j], 2 * STEP); | The back-most leg (at −28°) steps to the front (+28°)
shiftBody(-STEP); | Every hip goes back 14°: the body moves forward about 1.3 cm
standStill(); | At the end, bring every foot back to 0, one leg at a time

### 6.4 Activity: walk forward

Paste your calibration numbers, put the robot on the floor and upload:

Full sketch: P8_walk_forward.ino

Copy

// spider-bot-8 by DRODI | MIT licence | https://github.com/awd1779/spider-bot-8
// P8 - Walk forward (creep gait: one leg in the air at a time)
// Serial Monitor (115200 baud):  s = stand,  d = sit,  f = walk forward 2 cycles

#include <Wire.h>
#include <Adafruit_PWMServoDriver.h>

Adafruit_PWMServoDriver pca = Adafruit_PWMServoDriver(0x40);

// Legs: 0 rear-left, 1 rear-right, 2 front-right, 3 front-left
const int HIP_CH[4]  = {0, 4, 8, 12};
const int LIFT_CH[4] = {1, 5, 9, 13};

// ---- PASTE YOUR CALIBRATION HERE (from P6) ----
int HIP_TRIM[4]  = {0, 0, 0, 0};
int LIFT_TRIM[4] = {0, 0, 0, 0};
int HIP_DIR[4]   = {-1, 1, 1, -1};
int LIFT_DIR[4]  = {-1, -1, -1, -1};
// -----------------------------------------------

const int LIMIT = 35;          // never more than 35 degrees from centre
const float STAND = -15;       // lift angle when standing (foot pushed down)
const float SIT = 35;          // lift angle when sitting (feet up, body on the floor)

float hipNow[4], liftNow[4];   // where every joint is now
bool standing = false;        // true after standUp()

void writeServo(int ch, float deg) {
  pca.writeMicroseconds(ch, 500 + deg * 10.56);
}

// Put one leg at a hip angle (+ = forward) and a lift angle (+ = foot up)
void setLeg(int leg, float hip, float lift) {
  hip = constrain(hip, -LIMIT, LIMIT);
  lift = constrain(lift, -LIMIT, LIMIT);
  writeServo(HIP_CH[leg], 90 + HIP_DIR[leg] * hip + HIP_TRIM[leg]);
  writeServo(LIFT_CH[leg], 90 + LIFT_DIR[leg] * lift + LIFT_TRIM[leg]);
  hipNow[leg] = hip;
  liftNow[leg] = lift;
}

// Move all 4 legs together to new angles, taking ms milliseconds
void moveLegs(float hip[4], float lift[4], int ms) {
  float hip0[4], lift0[4];
  for (int i = 0; i < 4; i++) { hip0[i] = hipNow[i]; lift0[i] = liftNow[i]; }
  int steps = max(1, ms / 20);
  for (int s = 1; s <= steps; s++) {
    float f = (float)s / steps;                     // 0 -> 1
    for (int i = 0; i < 4; i++)
      setLeg(i, hip0[i] + (hip[i] - hip0[i]) * f, lift0[i] + (lift[i] - lift0[i]) * f);
    delay(20);
  }
}

void standUp() {
  float hip[4]  = {0, 0, 0, 0};
  float lift[4] = {STAND, STAND, STAND, STAND};
  moveLegs(hip, lift, 1500);
  standing = true;
}

void sitDown() {
  float hip[4]  = {0, 0, 0, 0};
  float lift[4] = {SIT, SIT, SIT, SIT};
  moveLegs(hip, lift, 1500);
  standing = false;
}

// ---- walking ----
const int STEP = 14;           // hip swing for one walking "unit" (degrees)
const float UP = 10;           // lift angle with the foot in the air

// Move just one leg; the other three stay where they are
void moveOneLeg(int leg, float hip, float lift, int ms) {
  float h[4], l[4];
  for (int i = 0; i < 4; i++) { h[i] = hipNow[i]; l[i] = liftNow[i]; }
  h[leg] = hip;
  l[leg] = lift;
  moveLegs(h, l, ms);
}

// Lift a leg, carry it to a new hip angle in the air, put it down
void stepLeg(int leg, float hip) {
  moveOneLeg(leg, hipNow[leg], UP, 150);     // 1. foot up
  moveOneLeg(leg, hip, UP, 200);             // 2. swing in the air
  moveOneLeg(leg, hip, STAND, 150);          // 3. foot down
}

// All 4 feet stay on the floor and every hip turns by "by" degrees.
// by < 0: the feet push back, so the body slides forward.
void shiftBody(float by) {
  float h[4], l[4];
  for (int i = 0; i < 4; i++) { h[i] = hipNow[i] + by; l[i] = liftNow[i]; }
  moveLegs(h, l, 300);
}

// Starting pattern for walking: the legs are at -2, -1, 0 and +1 units,
// in the order they will step (dir = +1 forward, -1 backward)
void getReady(const int order[4], int dir) {
  if (!standing) standUp();
  for (int j = 0; j < 4; j++) {
    int leg = order[j];
    float target = dir * (j - 2) * STEP;
    if (hipNow[leg] != target) stepLeg(leg, target);
  }
}

// Put every foot back to hip 0, one leg at a time
void standStill() {
  for (int leg = 0; leg < 4; leg++)
    if (hipNow[leg] != 0) stepLeg(leg, 0);
}

// Leg order for walking forward: rear-left, front-left, rear-right, front-right
const int FWD_ORDER[4] = {0, 3, 1, 2};

void walkForward(int cycles) {
  getReady(FWD_ORDER, +1);
  for (int c = 0; c < cycles; c++) {
    for (int j = 0; j < 4; j++) {
      stepLeg(FWD_ORDER[j], 2 * STEP);   // the back-most leg steps to the front
      shiftBody(-STEP);                  // all feet push back: the body moves forward
    }
  }
  standStill();
}

void setup() {
  Serial.begin(115200);
  Wire.begin();
  pca.begin();
  pca.setOscillatorFrequency(27000000);
  pca.setPWMFreq(50);
  delay(10);
  for (int leg = 0; leg < 4; leg++) { setLeg(leg, 0, SIT); delay(300); }   // start sitting
  Serial.println("s = stand, d = sit, f = forward");
}

void loop() {
  if (Serial.available() == 0) return;
  char c = Serial.read();
  if (c == 's') { Serial.println("Standing up"); standStill(); standUp(); }
  if (c == 'd') { Serial.println("Sitting down"); standStill(); sitDown(); }
  if (c == 'f') { Serial.println("Forward"); walkForward(2); }
}

Type f to walk 2 cycles forward (8 steps). Type d to sit when you've finished.

If it doesn't walk well

Problem | Try
A foot drags on the floor when it swings | Raise UP from 10 to 15
It tips towards the lifted leg | Check the batteries are in the middle of the body; increase STEP to 16 (wider spread)
It walks in a curve | Check the hip trims: at 0 all 4 shoulders must point exactly diagonally
It sags or a servo buzzes | Fresh batteries. Or move STAND closer to −20 (feet further in)
A leg moves backward when it should go forward | That leg's hip DIR is wrong: run P6 test again

Try it:

- Make it walk faster. Which numbers would you change? What goes wrong if you go too fast?
- Change walkForward(2) so it walks 5 cycles.

Check yourself (Chapter 6)

- What is the centre of mass, and why must it stay inside the triangle of feet?
- In what order do the legs step?
- During the shift, all 4 feet push back. Why does the body move forward?
- What would happen if all 4 legs stood at hip = 0 and one leg lifted?

## Chapter 7 · Walk backward

### 7.1 The idea: play it backwards

Walking backward is walking forward played in reverse:

| Forward | Backward
Leg order | rear-left, front-left, rear-right, front-right | front-right, rear-right, front-left, rear-left (reversed)
Which leg steps | the back-most one | the front-most one
It steps to | +2 steps (the front) | −2 steps (the back)
The shift | hips −14°: body goes forward | hips +14°: body goes backward

Click Backward on the gait diagram in 6.2 to watch it.

### 7.2 The code

getReady, stepLeg, shiftBody and standStill stay exactly the same. We add the reversed order and one new function:

Copy

// Leg order for walking backward: the forward order, reversed
const int BACK_ORDER[4] = {2, 1, 3, 0};   // front-right, rear-right, front-left, rear-left

void walkBackward(int cycles) {
  getReady(BACK_ORDER, -1);
  for (int c = 0; c < cycles; c++) {
    for (int j = 0; j < 4; j++) {
      stepLeg(BACK_ORDER[j], -2 * STEP);  // the front-most leg steps to the back
      shiftBody(+STEP);                   // all feet push forward: the body moves back
    }
  }
  standStill();
}

Code | What it does
BACK_ORDER[4] = {2, 1, 3, 0} | FWD_ORDER {0, 3, 1, 2} backwards
getReady(BACK_ORDER, -1); | dir = −1 flips the pattern: +28°, +14°, 0°, −14°
stepLeg(BACK_ORDER[j], -2 * STEP); | The front-most leg steps to the back
shiftBody(+STEP); | Every hip goes forward 14°: the body moves back

### 7.3 Activity: the whole robot

This sketch has everything: stand, sit, forward and backward. Paste your calibration numbers and upload:

Full sketch: P9_walk_backward.ino

Copy

// spider-bot-8 by DRODI | MIT licence | https://github.com/awd1779/spider-bot-8
// P9 - Walk forward and backward: the whole robot
// Serial Monitor (115200 baud):  s = stand,  d = sit,  f = forward,  b = backward

#include <Wire.h>
#include <Adafruit_PWMServoDriver.h>

Adafruit_PWMServoDriver pca = Adafruit_PWMServoDriver(0x40);

// Legs: 0 rear-left, 1 rear-right, 2 front-right, 3 front-left
const int HIP_CH[4]  = {0, 4, 8, 12};
const int LIFT_CH[4] = {1, 5, 9, 13};

// ---- PASTE YOUR CALIBRATION HERE (from P6) ----
int HIP_TRIM[4]  = {0, 0, 0, 0};
int LIFT_TRIM[4] = {0, 0, 0, 0};
int HIP_DIR[4]   = {-1, 1, 1, -1};
int LIFT_DIR[4]  = {-1, -1, -1, -1};
// -----------------------------------------------

const int LIMIT = 35;          // never more than 35 degrees from centre
const float STAND = -15;       // lift angle when standing (foot pushed down)
const float SIT = 35;          // lift angle when sitting (feet up, body on the floor)

float hipNow[4], liftNow[4];   // where every joint is now
bool standing = false;        // true after standUp()

void writeServo(int ch, float deg) {
  pca.writeMicroseconds(ch, 500 + deg * 10.56);
}

// Put one leg at a hip angle (+ = forward) and a lift angle (+ = foot up)
void setLeg(int leg, float hip, float lift) {
  hip = constrain(hip, -LIMIT, LIMIT);
  lift = constrain(lift, -LIMIT, LIMIT);
  writeServo(HIP_CH[leg], 90 + HIP_DIR[leg] * hip + HIP_TRIM[leg]);
  writeServo(LIFT_CH[leg], 90 + LIFT_DIR[leg] * lift + LIFT_TRIM[leg]);
  hipNow[leg] = hip;
  liftNow[leg] = lift;
}

// Move all 4 legs together to new angles, taking ms milliseconds
void moveLegs(float hip[4], float lift[4], int ms) {
  float hip0[4], lift0[4];
  for (int i = 0; i < 4; i++) { hip0[i] = hipNow[i]; lift0[i] = liftNow[i]; }
  int steps = max(1, ms / 20);
  for (int s = 1; s <= steps; s++) {
    float f = (float)s / steps;                     // 0 -> 1
    for (int i = 0; i < 4; i++)
      setLeg(i, hip0[i] + (hip[i] - hip0[i]) * f, lift0[i] + (lift[i] - lift0[i]) * f);
    delay(20);
  }
}

void standUp() {
  float hip[4]  = {0, 0, 0, 0};
  float lift[4] = {STAND, STAND, STAND, STAND};
  moveLegs(hip, lift, 1500);
  standing = true;
}

void sitDown() {
  float hip[4]  = {0, 0, 0, 0};
  float lift[4] = {SIT, SIT, SIT, SIT};
  moveLegs(hip, lift, 1500);
  standing = false;
}

// ---- walking ----
const int STEP = 14;           // hip swing for one walking "unit" (degrees)
const float UP = 10;           // lift angle with the foot in the air

// Move just one leg; the other three stay where they are
void moveOneLeg(int leg, float hip, float lift, int ms) {
  float h[4], l[4];
  for (int i = 0; i < 4; i++) { h[i] = hipNow[i]; l[i] = liftNow[i]; }
  h[leg] = hip;
  l[leg] = lift;
  moveLegs(h, l, ms);
}

// Lift a leg, carry it to a new hip angle in the air, put it down
void stepLeg(int leg, float hip) {
  moveOneLeg(leg, hipNow[leg], UP, 150);     // 1. foot up
  moveOneLeg(leg, hip, UP, 200);             // 2. swing in the air
  moveOneLeg(leg, hip, STAND, 150);          // 3. foot down
}

// All 4 feet stay on the floor and every hip turns by "by" degrees.
// by < 0: the feet push back, so the body slides forward.
void shiftBody(float by) {
  float h[4], l[4];
  for (int i = 0; i < 4; i++) { h[i] = hipNow[i] + by; l[i] = liftNow[i]; }
  moveLegs(h, l, 300);
}

// Starting pattern for walking: the legs are at -2, -1, 0 and +1 units,
// in the order they will step (dir = +1 forward, -1 backward)
void getReady(const int order[4], int dir) {
  if (!standing) standUp();
  for (int j = 0; j < 4; j++) {
    int leg = order[j];
    float target = dir * (j - 2) * STEP;
    if (hipNow[leg] != target) stepLeg(leg, target);
  }
}

// Put every foot back to hip 0, one leg at a time
void standStill() {
  for (int leg = 0; leg < 4; leg++)
    if (hipNow[leg] != 0) stepLeg(leg, 0);
}

// Leg order for walking forward: rear-left, front-left, rear-right, front-right
const int FWD_ORDER[4] = {0, 3, 1, 2};

void walkForward(int cycles) {
  getReady(FWD_ORDER, +1);
  for (int c = 0; c < cycles; c++) {
    for (int j = 0; j < 4; j++) {
      stepLeg(FWD_ORDER[j], 2 * STEP);   // the back-most leg steps to the front
      shiftBody(-STEP);                  // all feet push back: the body moves forward
    }
  }
  standStill();
}

// Leg order for walking backward: the forward order, reversed
const int BACK_ORDER[4] = {2, 1, 3, 0};   // front-right, rear-right, front-left, rear-left

void walkBackward(int cycles) {
  getReady(BACK_ORDER, -1);
  for (int c = 0; c < cycles; c++) {
    for (int j = 0; j < 4; j++) {
      stepLeg(BACK_ORDER[j], -2 * STEP);  // the front-most leg steps to the back
      shiftBody(+STEP);                   // all feet push forward: the body moves back
    }
  }
  standStill();
}

void setup() {
  Serial.begin(115200);
  Wire.begin();
  pca.begin();
  pca.setOscillatorFrequency(27000000);
  pca.setPWMFreq(50);
  delay(10);
  for (int leg = 0; leg < 4; leg++) { setLeg(leg, 0, SIT); delay(300); }   // start sitting
  Serial.println("s = stand, d = sit, f = forward, b = backward");
}

void loop() {
  if (Serial.available() == 0) return;
  char c = Serial.read();
  if (c == 's') { Serial.println("Standing up"); standStill(); standUp(); }
  if (c == 'd') { Serial.println("Sitting down"); standStill(); sitDown(); }
  if (c == 'f') { Serial.println("Forward"); walkForward(2); }
  if (c == 'b') { Serial.println("Backward"); walkBackward(2); }
}

Type | The robot
s | stands up
d | sits down
f | walks forward 2 cycles
b | walks backward 2 cycles

Challenges

1. A dance: stand, walk forward 1 cycle, backward 1 cycle, sit, stand, then sit again. Do it with a new command, x.
2. Turn on the spot: when the robot turns, every foot moves the same way round the body, not forward. Hint: make a turnBody(by) that adds by to the right legs' hips (1 and 2) and subtracts it from the left legs' hips (0 and 3).
3. Stop before a wall: add the ultrasonic sensor on the front. Walk forward one cycle at a time, and sit down when something is closer than 15 cm.

Check yourself (Chapter 7)

- What 3 things change between walking forward and walking backward?
- Why can stepLeg and shiftBody stay the same?
- Your robot can stand, sit, walk forward and walk backward

## Chapter 8 · The easy way: the SpiderBot8 library

In Chapters 5 to 7 you wrote setLeg, moveLegs, stepLeg, shiftBody and the gait yourself. A library packs code like this into one file you can reuse, so a whole program can be a few lines long. Professional programmers use libraries all the time: you've been using one since Chapter 3 (Adafruit_PWMServoDriver).

### 8.1 Install it

1. Download SpiderBot8.zip from the project page: github.com/awd1779/spider-bot-8, in the library folder.
2. In Arduino IDE: Sketch → Include Library → Add .ZIP Library... and choose the zip.
3. The examples appear under File → Examples → SpiderBot8.

### 8.2 Calibrate with the library

Open the example 04_Calibrate. It works just like P6 (4.9): h, l, test, fh, fl. When you type print, it prints lines like these, ready to paste just after robot.begin();:

robot.setTrim(REAR_LEFT, 3, -2);
robot.setDirection(REAR_LEFT, -1, -1);

### 8.3 A whole walk in a few lines

Copy

// SpiderBot8 example 2: walk a square-ish path, then sit down
#include <SpiderBot8.h>

SpiderBot robot;

void setup() {
  robot.begin();

  // ---- paste your calibration from 04_Calibrate here ----
  robot.setTrim(REAR_LEFT,   0, 0);
  robot.setTrim(REAR_RIGHT,  0, 0);
  robot.setTrim(FRONT_RIGHT, 0, 0);
  robot.setTrim(FRONT_LEFT,  0, 0);
  // ---------------------------------------------------------

  delay(1000);
  robot.standUp();
  robot.walkForward(8);   // 8 steps, about 10 cm
  robot.turnLeft(8);      // about 50 degrees
  robot.walkForward(8);
  robot.walkBackward(8);
  robot.turnRight(8);
  robot.wave();
  robot.sitDown();
}

void loop() {
}

Code | What it does
SpiderBot robot; | Makes a robot object called robot
robot.begin(); | Starts the servo module. The robot sits
robot.setTrim(REAR_LEFT, 0, 0); | Your calibration: hip and lift trim for one leg
robot.walkForward(8); | 8 steps of the crawl gait from Chapter 6, about 1.3 cm each
robot.turnLeft(8); | Turns on the spot, about 6° per step
robot.wave(); | Leans back, then waves the front-right leg

### 8.4 All the commands

Command | What it does
standUp(), sitDown() | Stand up, sit down
walkForward(steps), walkBackward(steps) | Walk. 4 steps = one full cycle
turnLeft(steps), turnRight(steps) | Turn on the spot
wave(times), pushUps(times) | Fun moves
moveLeg(leg, hip, lift, ms) | Move one leg smoothly (your own moves)
moveLegs(hips, lifts, ms) | Move all 4 legs together, smoothly
setSpeed(percent) | 100 = normal, 200 = twice as fast
setStandHeight(lift), setStepSize(hip), setStepHeight(lift) | Change how it stands and walks
relax() | Switch the servos off to save the batteries

How does turning work? Walking moves every foot forward or back. Turning moves the right feet forward and the left feet back, so every foot goes the same way round the body. The gait is the same crawl: one foot in the air at a time, legs one step apart. When turning, the centre of mass stays even further inside the triangle than when walking.

### 8.5 Activity: your own program

Open 03_SerialControl to drive the robot from the keyboard (f, b, l, r, s, d, w). Then open 05_MyOwnMoves and look at how rock() and nod() use moveLegs to make new moves.

Challenges

1. Make the robot walk a square: forward, turn, forward, turn ... until it's back where it started. How many turn steps make 90°?
2. Make up a dance with at least 3 of your own moves, using moveLeg or moveLegs.
3. With the ultrasonic sensor: walk forward 4 steps at a time; if something is closer than 15 cm, turn left 8 steps instead.

Check yourself (Chapter 8)

- What is a library, and why is it useful?
- Which line in your sketch holds your calibration numbers?
- How is turning different from walking?

## Troubleshooting and glossary

Problem | Likely cause | Fix
Scanner finds nothing | I2C wires | Check VCC to 3V3, GND to GND, SDA to 21, SCL to 22. Try swapping SDA and SCL
Servos don't move, scanner finds 0x40 | No servo power | Battery switch on? Red to V+, black to GND in the green terminal?
ESP32 keeps restarting when servos move | Servos powered from USB | Servo power must come from the batteries, through the green terminal
Upload fails: "Failed to connect" | ESP32 not in upload mode | Hold BOOT until the upload starts
One servo jitters | Weak batteries or a loose plug | Fresh batteries; push the plug in fully, brown on GND
A leg points the wrong way at 0 | Horn a tooth out | Run P5, refit the horn, calibrate again
Robot sinks or wobbles when standing | Not enough strength | Fresh batteries; STAND −20; lower infill to make the body lighter

Glossary

Word | Meaning
Servo | A motor that turns to an angle and holds it
Pulse | A short "on" signal; its length tells the servo the angle
µs | Microsecond: one millionth of a second
PCA9685 | The 16-channel servo module
I2C | Two-wire bus (SDA + SCL) that lets chips talk
Channel | One of the module's 16 servo outputs (0–15)
Horn | The plastic arm that fits on the servo's shaft
Spline | The teeth on the shaft that the horn grips
Trim | A small correction, in degrees, for one joint
Hip / lift | The servo that swings a leg forward and back / up and down
Centre of mass | The point where the robot's weight acts
Support triangle | The area between the feet on the floor
Creep gait | Walking with one leg in the air at a time
Library | Ready-made code you add to a sketch with #include
