awd1779/spider-bot-8/docs/images/assembled_top.png

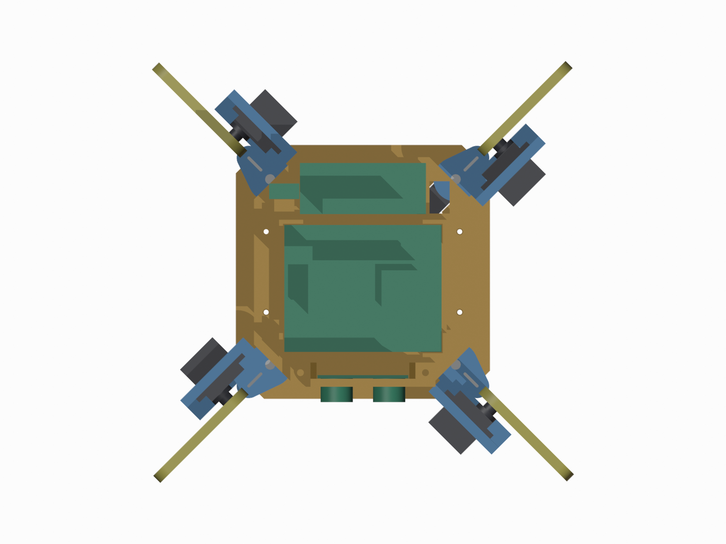
docs/images/assembled_top.png
