awd1779/spider-bot-8/(commit log)

2026-10-23 spider-bot-8 v1.0: 8-servo ESP32 spider robot
    - 3D-printable parts (STL), editable CAD (STEP) and the parametric FreeCAD script
    - Firmware P1-P9: servo module, servo control, calibration, stand/sit, crawl-gait walking forward and backward
    - Offline student manual (docs/manual.html) and its source
    [assembly.step, body_bottom.step, body_bottom.stl, body_top.step, body_top.stl, coxa.step, coxa.stl, fit_test.step]
2026-10-23 Add the SpiderBot8 Arduino library and manual chapter 8
    - library/SpiderBot8: standUp, sitDown, walkForward/Backward, turnLeft/Right, wave,
    pushUps, moveLeg(s), speed and calibration settings; 5 examples; installable zip
    - Turning uses the same crawl gait with the feet moving round the body
    - Manual: new chapter 8 on using the library
